Fozle/Bird-sound-detector-edge-ai/Screenshots/Screenshot_1.png

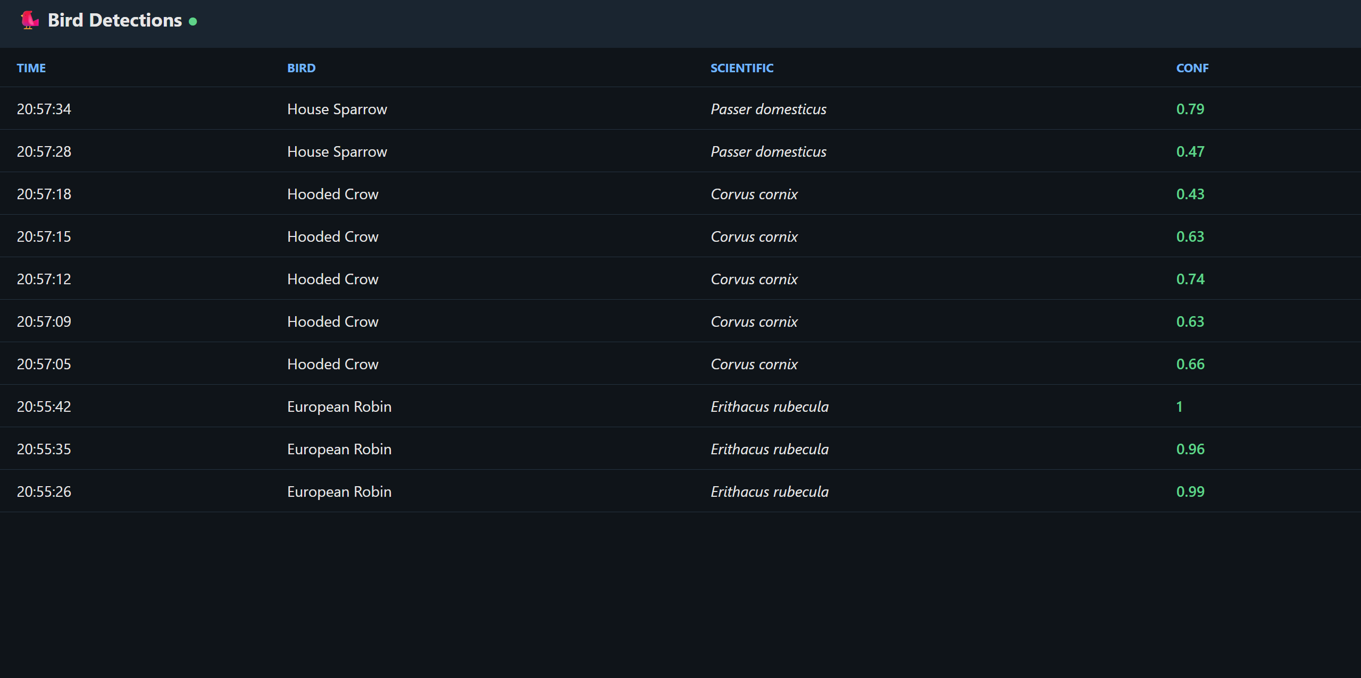
Screenshots/Screenshot_1.png
