Fozle/Bird-sound-detector-edge-ai/Screenshots/Screenshot_2.png

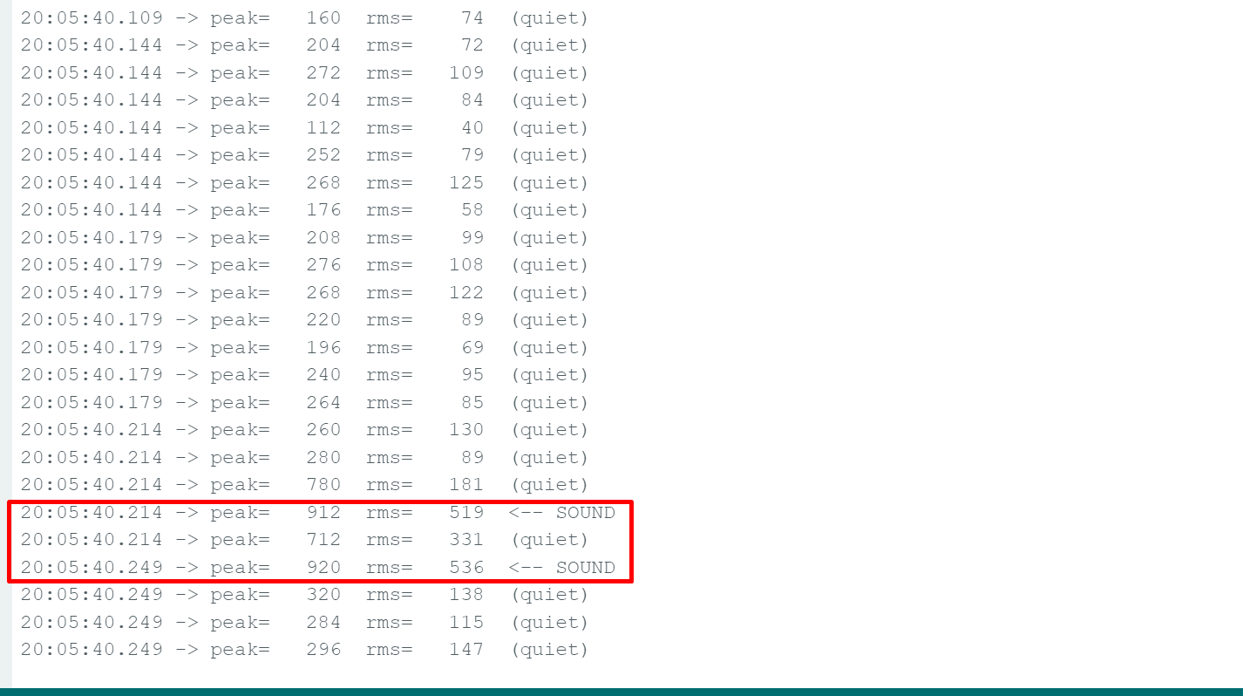
Screenshots/Screenshot_2.png
