Fozle/Bird-sound-detector-edge-ai/Screenshots/Screenshot_4.png

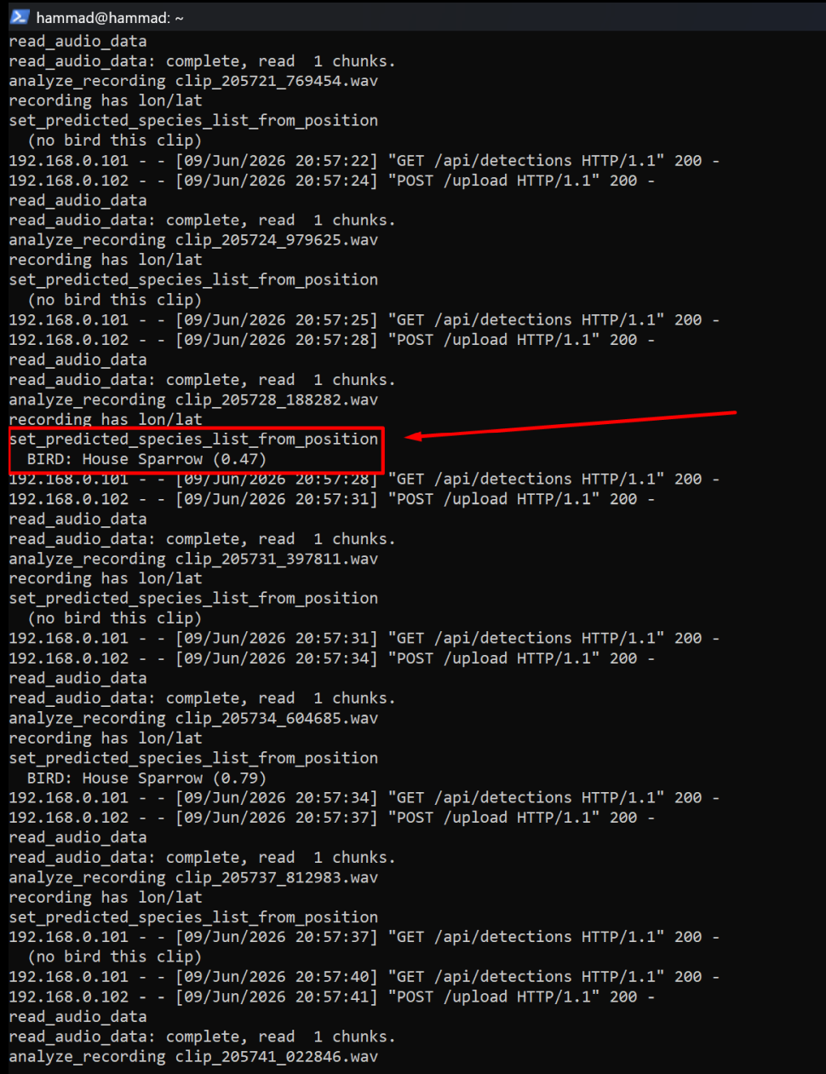
Screenshots/Screenshot_4.png
